khasegh/AirMonitor/image/lib.png

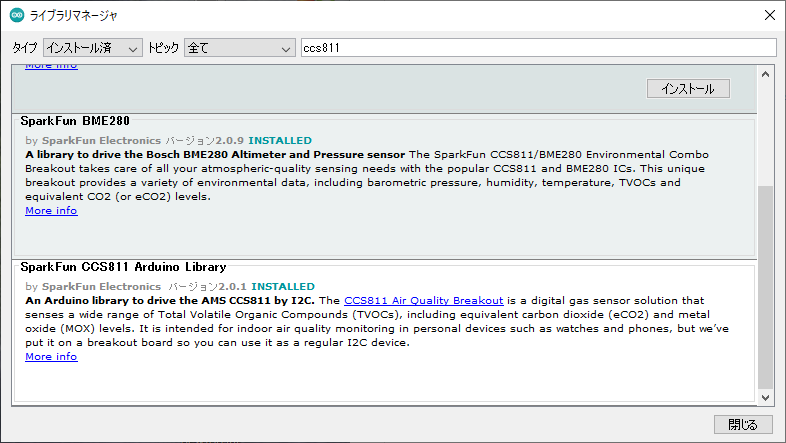
image/lib.png
