khasegh/AirMonitor/(commit log)

2021-02-11 Add files via upload
    CO2棒グラフの基準を変更
2021-02-12 Add files via upload
    ライブラリ画面
2021-03-01 輝度調整しない場合を追記
2021-03-04 グラフの歪み回避について追記
